LZH-ang/8051_digital-clock/README.md

# 8051_digital clock_myfristrepository!
look! u found me! 

it's my frist repository!

PCB SOFTWARE : AD20.2.8

PROGRAMME SOFTWARE : KEIL V5.34

MCU : STC8H1K17

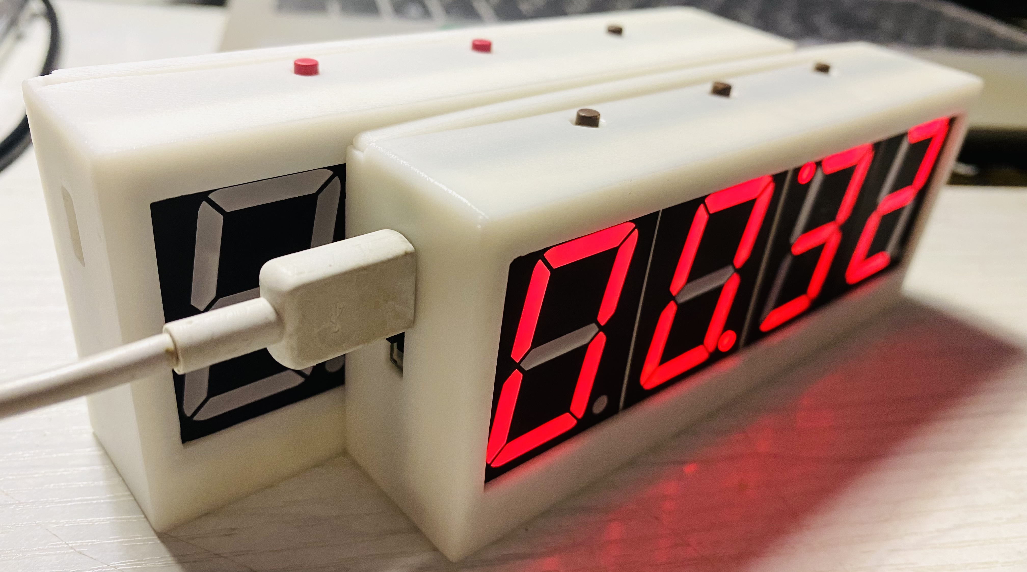
[picture p1: IMG/IMG_1017.JPG]
