LZH-ang/8051_digital-clock/8051_eclock_DEMO/Code/三菱按键/”三菱“开关编程分享/2IO检测6按键原理图分析 - 哔哩哔哩 - www.bilibili.com.pdf

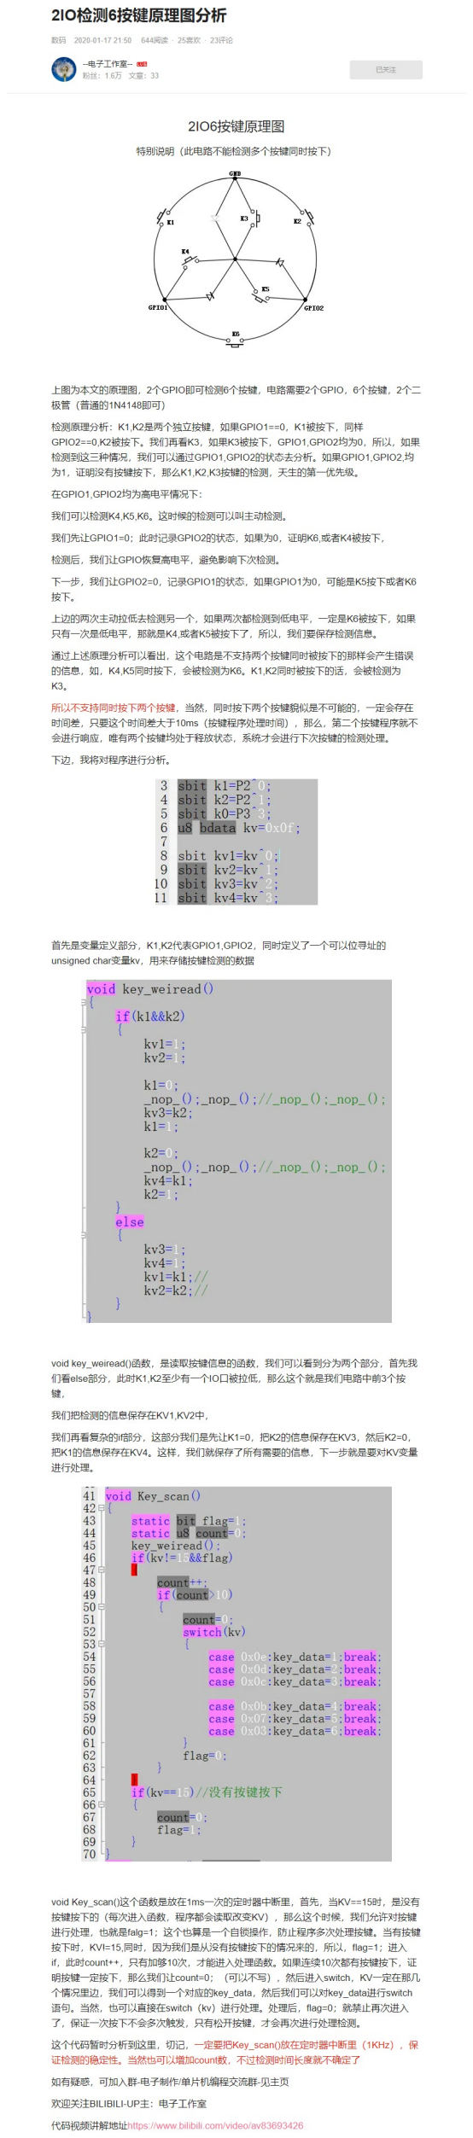
[picture p2: page 1]
