LZH-ang/8051_digital-clock/8051_eclock_DEMO/Code/三菱按键/”三菱“开关编程分享/2个IO检测6个按键.png

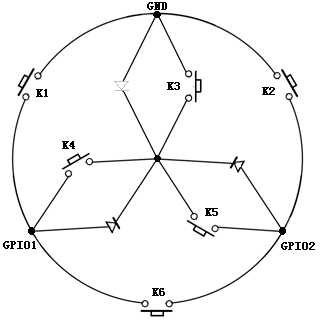
8051_eclock_DEMO/Code/三菱按键/”三菱“开关编程分享/2个IO检测6个按键.png
