LZH-ang/8051_digital-clock/8051_eclock_DEMO/PCB file/1W LED 驱动器700mA PWM调光输入5-35V DC-DC恒流模块-淘宝网 - item.taobao.com.png

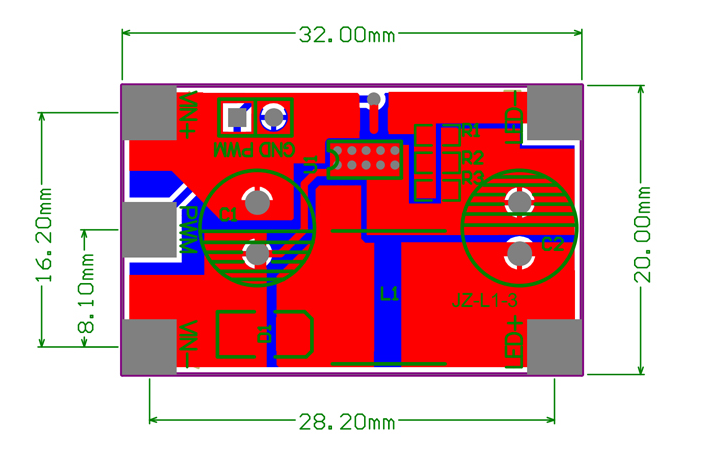
8051_eclock_DEMO/PCB file/1W LED 驱动器700mA PWM调光输入5-35V DC-DC恒流模块-淘宝网 - item.taobao.com.png
