LZH-ang/8051_digital-clock/8051_eclock_DEMO/PCB file/PCB.png

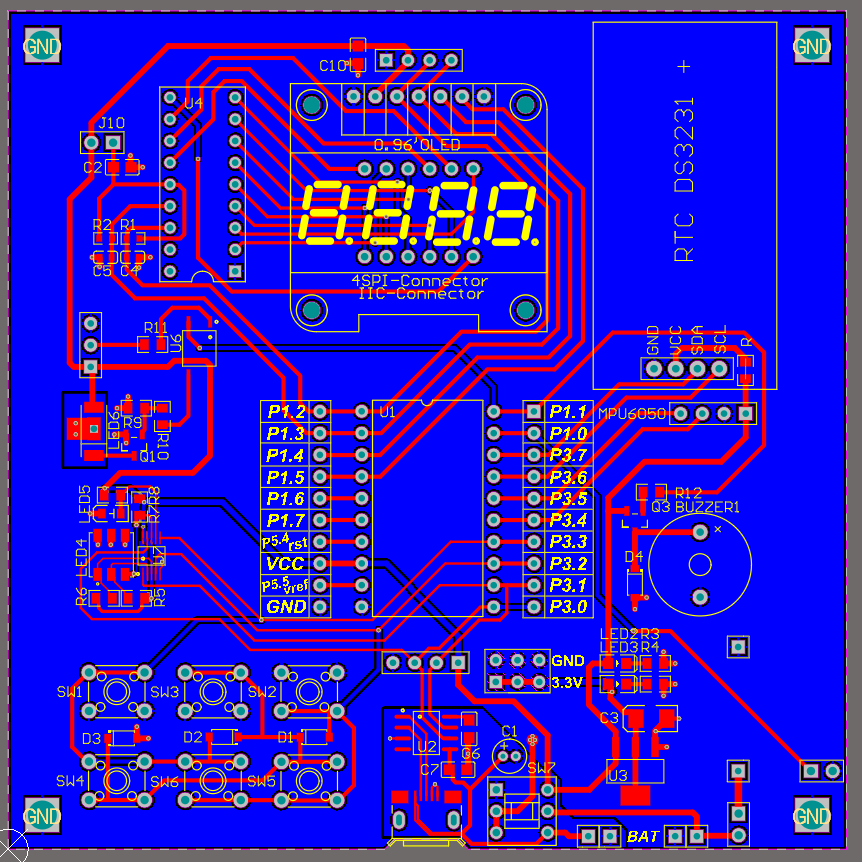
8051_eclock_DEMO/PCB file/PCB.png
