LZH-ang/8051_digital-clock/IMG/IMG_1015.JPG

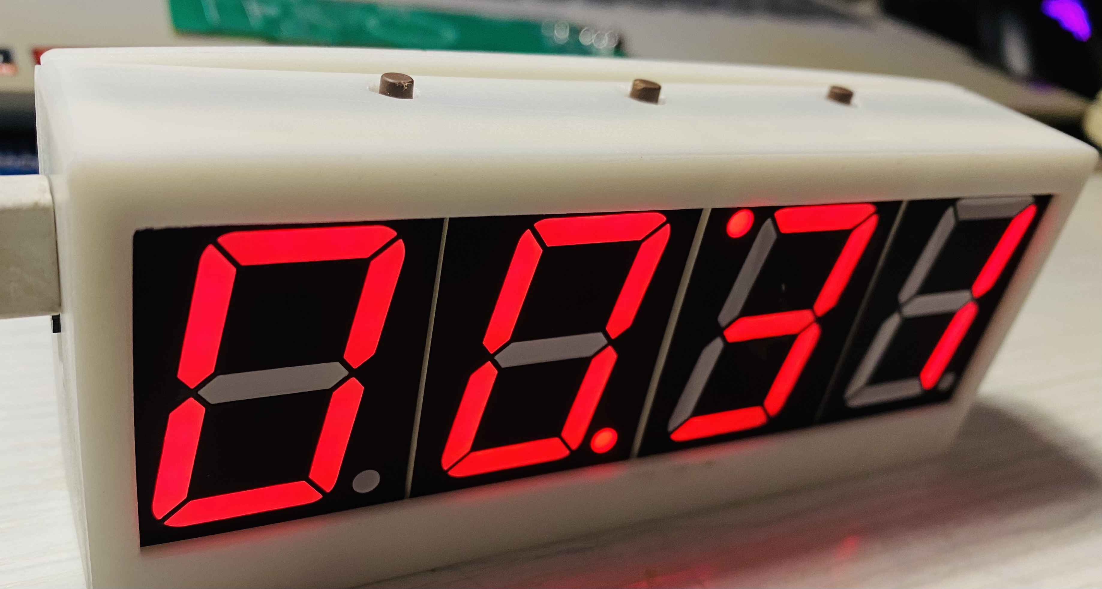
IMG/IMG_1015.JPG
