LZH-ang/8051_digital-clock/IMG/IMG_1016.JPG

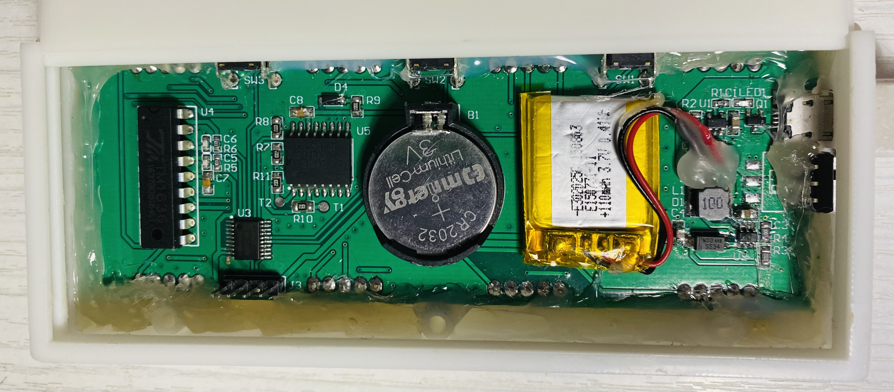
IMG/IMG_1016.JPG
