LZH-ang/8051_digital-clock/8051_eclock/工程文件 file project/PCB_Project/床头表PCB_Project.pdf

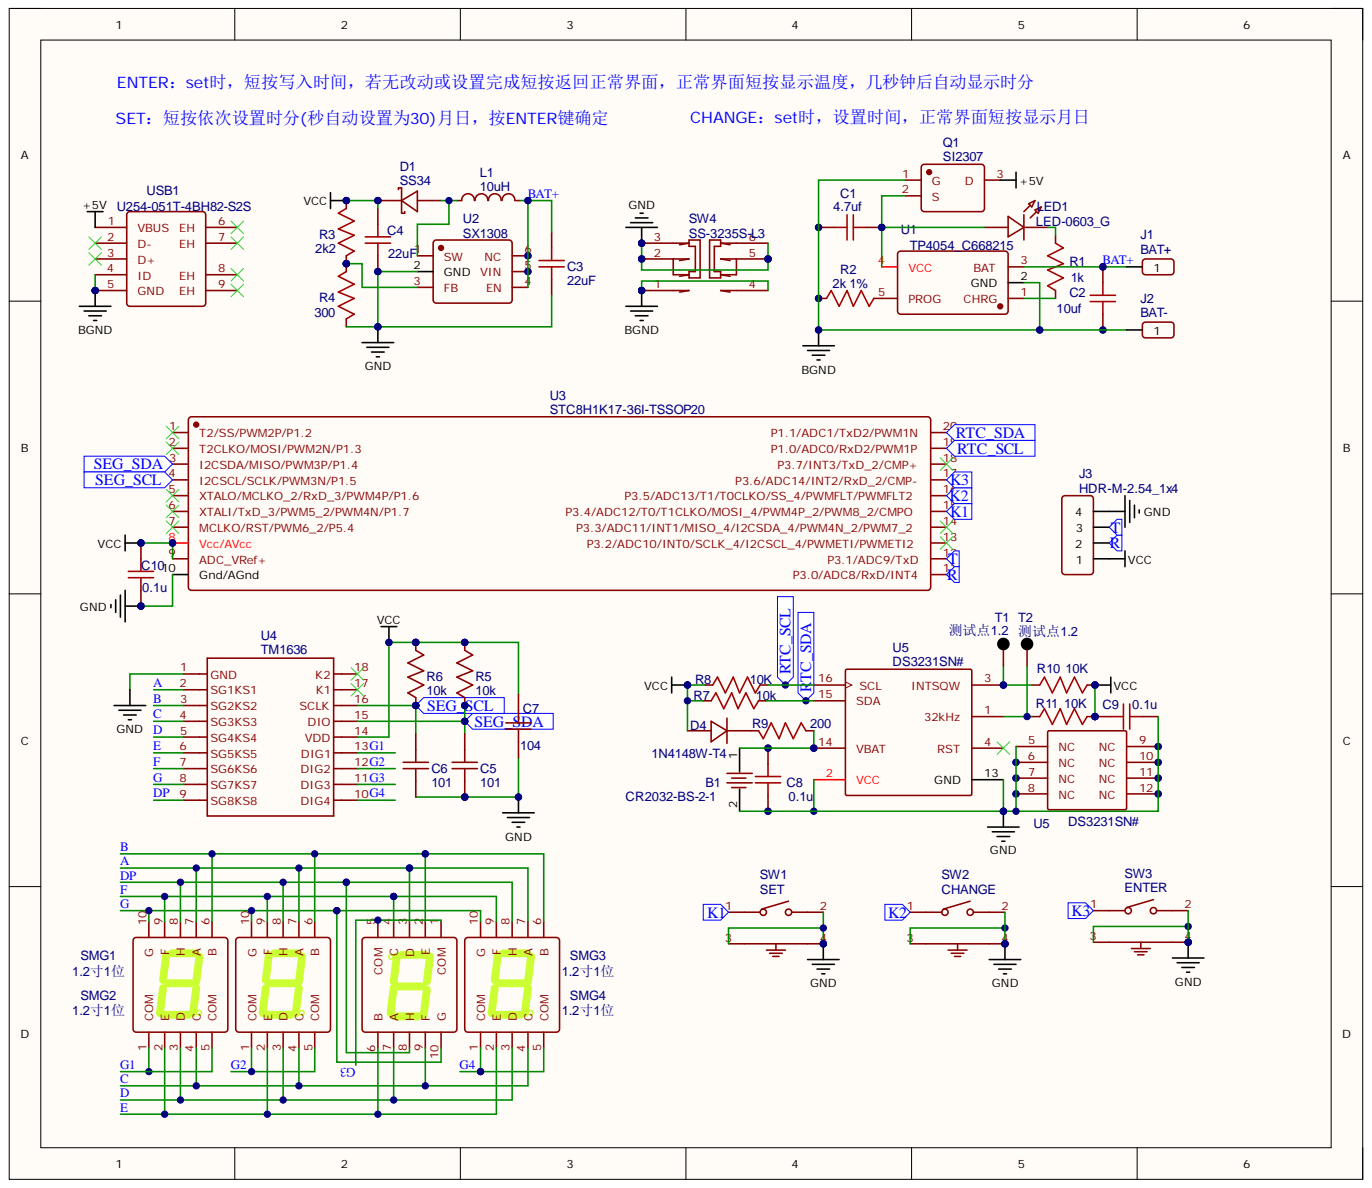
[picture p8: page 1]

ENTER：set时，短按写入时间，若无改动或设置完成短按返回正常界面，正常界面短按显示温度，几秒钟后自动显示时分

SET：短按依次设置时分(秒自动设置为30)月日，按ENTER键确定

CHANGE：set时，设置时间，正常界面短按显示月日

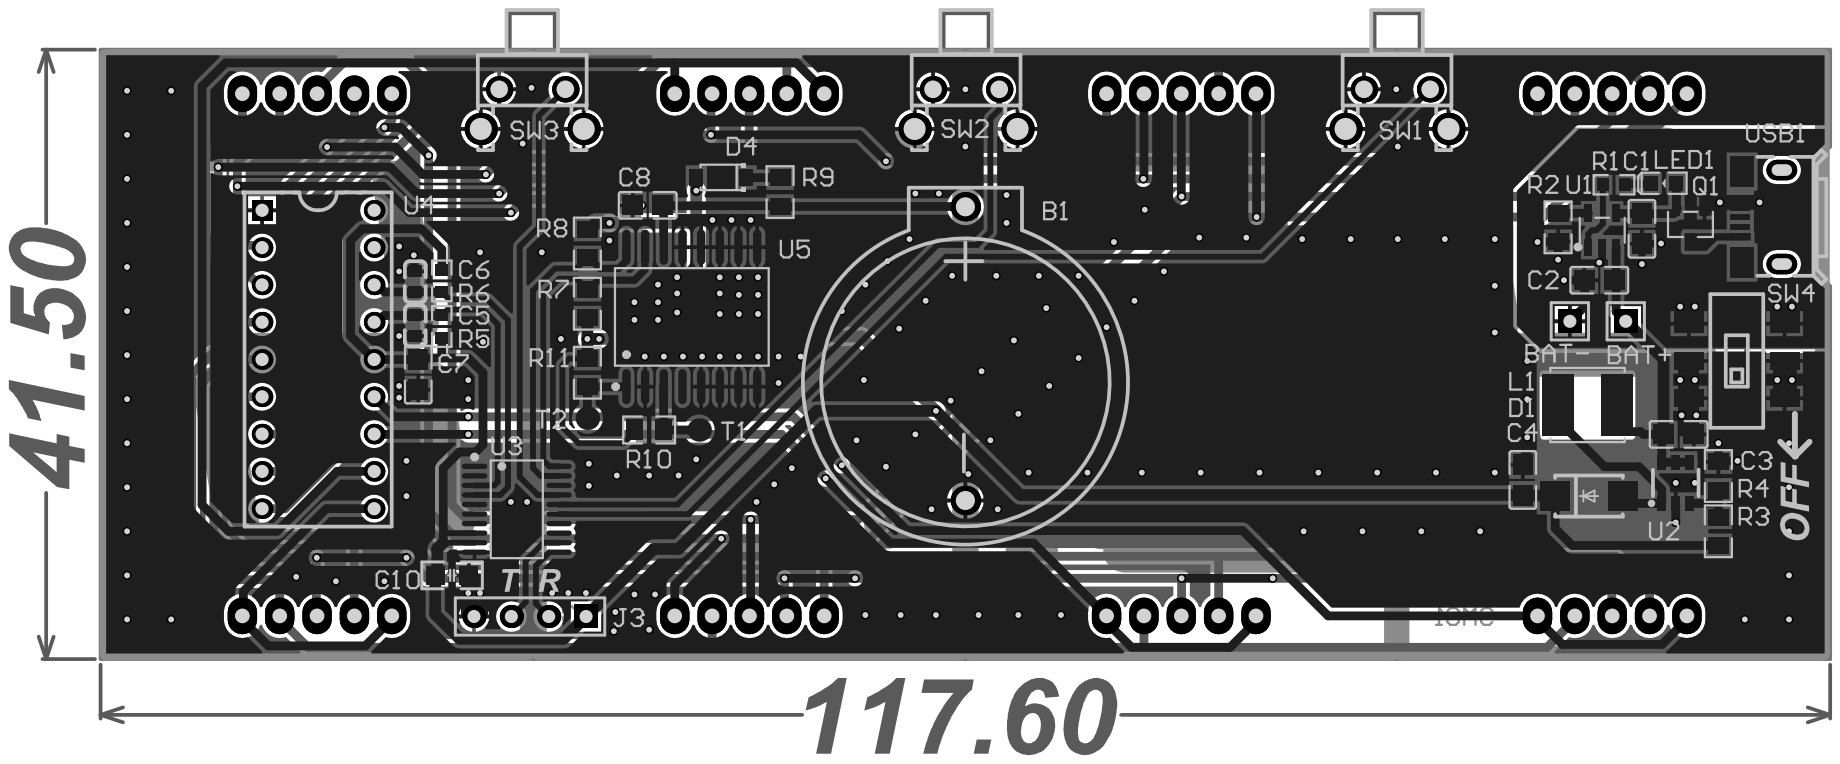
[picture p9: page 2]

Comment | Description | Designator | Footprint | LibRef | Quantity
CR2032-BS-2-1 | | B1 | BAT-TH_BS-2-1 | CR2032-BS-2-1 | 1
4.7uf | | C1 | C0805 | 4.7uf | 1
10uf | | C2 | C0805 | 10uf | 1
22uF | | C3, C4 | C0805 | 22uF | 2
101 | | C5, C6 | C0603 | 101 | 2
104 | | C7 | C0805 | 104 | 1
0.1u | | C8, C9, C10 | C0805 | 0.1u | 3
SS34 | | D1 | DO-214AC_L4.3-W2.7-LS5.3-RD | SS34 | 1
1N4148W-T4 | | D4 | SOD-123_L2.8-W1.8-LS3.7-RD | 1N4148W-T4 | 1
BAT+ | | J1 | HDR-M-2.54_1X1 | BAT+ | 1
BAT- | | J2 | HDR-M-2.54_1X1 | BAT- | 1
HDR-M-2.54_1x4 | | J3 | HDR-M-2.54_1X4 | HDR-M-2.54_1x4 | 1
10uH | | L1 | IND-SMD_L5.0-W5.0 10uH | | 1
LED-0603_G | | LED1 | LED0603_GREEN | LED-0603_G | 1
SI2307 | | Q1 | SOT-23-3_L3.0-W1.7-P0.95-LS2.9-BR | SI2307 | 1
1k | | R1 | R0603 | 1k | 1
2k 1% | | R2 | R0805 | 2k 1% | 1
2k2 | | R3 | R0805 | 2k2 | 1
300 | | R4 | R0805 | 300 | 1
10k | | R5, R6 | R0603 | 10k | 2
10k | | R7, R8, R10, R11 | R0805 | 10k | 4
200 | | R9 | R0805 | 200 | 1
1.2寸1位 | | SMG1, SMG2, SMG3, SMG4 | 1.2寸数码管 | 1.2寸1位 | 4
SET | | SW1 | SW-TH_TC-1102N-C-QL-B | SET | 1
CHANGE | | SW2 | SW-TH_TC-1102N-C-QL-B | CHANGE | 1
ENTER | | SW3 | SW-TH_TC-1102N-C-QL-B | ENTER | 1
SS-3235S-L3 | | SW4 | SW-SMD_SS-3235S-L3.00 | SS-3235S-L3 | 1
测试点1.2 | | T1, T2 | 测试点 | 测试点1.2 | 2
TP4054_C668215 | | U1 | SOT-23-5_L3.0-W1.7-P0.95-LS2.8-BL | TP4054_C668215 | 1
SX1308 | | U2 | SOT-23-6_L2.9-W1.6-P0.95-LS2.8-BR | SX1308 | 1
STC8H1K17-36I-TSSOP20 | | U3 | TSSOP-20_L6.5-W4.4-P0.65-LS6.4-BL | STC8H1K17-36I-TSSOP20 | 1
TM1636 | | U4 | DIP18-2.54-22.8X7.62MM | TM1636 | 1
DS3231SN# | | U5 | SOIC-16_L10.3-W7.5-P1.27-LS10.3-BL | DS3231SN# | 2
U254-051T-4BH82-S2S | | USB1 | MICRO-USB-SMD_U254-051T-4BH82-S2S | U254-051T-4BH82-S2S | 1
