LZH-ang/8051_digital-clock/(list of files, drawings)

Other design files:
8051_eclock/工程文件 file project/PCB_Project/PCB_床头灯_2022-02-08.pcbdoc
8051_eclock/工程文件 file project/PCB_Project/sch_2022-04-21.schdoc
8051_eclock/工程文件 file project/PCB_Project/床头表PCB_Project.PrjPcb
8051_eclock_DEMO/PCB file/Project file/PCB_STC8方案测试板_2022-01-08.pcbdoc
8051_eclock_DEMO/PCB file/Project file/sch_2022-04-21.schdoc
8051_eclock_DEMO/PCB file/Project file/stc8-PCB_Project/stc8-PCB_Project.PrjPcb
