LZH-ang/8051_digital-clock/8051_eclock/工程文件 file project/Program_V1.0/main.c

#include <STC8.H>
#include "intrins.h"
#include "delay.h"
#include "3231.h"
#include "TM1637.h"
#include "key.h"

u8 const num[10]={0x3F,0x06,0x5B,0x4F,0x66,0x6D,0x7D,0x07,0x7f,0x6F};
u8 sec_dot=0,cp=0,light=3;
bit light_con=0,TM0_flag=0;//自动亮度控制
	
void get_Temperature();	 //温度获取 显示
void Timer0Init(void)		//5毫秒@11.0592MHz
{
	AUXR |= 0x80;		//定时器时钟1T模式
	TMOD &= 0xF0;		//设置定时器模式
	TL0 = 0x00;		//设置定时初始值
	TH0 = 0x28;		//设置定时初始值
	TF0 = 0;		//清除TF0标志
	TR0 = 1;		//定时器0开始计时
	ET0 = 1;
	EA = 1;
}

void main()
{
	P1M0 = 0x30;//开漏
	P1M1 = 0x30;
	P3M1 = 0x00;//准双向
	P3M0 = 0x00;
	Timer0Init();
	while(cp<=20);cp = 0;//等待供电稳定
//	ModifyTime(DS3231_SECOND,30);_nop_();//测试用
//	ModifyTime(DS3231_MINUTE,8);_nop_();
//	ModifyTime(DS3231_HOUR,22);_nop_();
//	ModifyTime(DS3231_YEAR,22);_nop_();
//	ModifyTime(DS3231_MONTH,1);_nop_();
//	ModifyTime(DS3231_DAY,15);_nop_();
//	ModifyTime(DS3231_WEEK,7);_nop_();
	while(1)
	{
		Key_Set();
		Key_Change();
		Key_Enter();	
		if(cp ==70)//每大约300ms读一次时间
		{
			cp = 0;
			year = read_random(DS3231_YEAR);_nop_();
			mon  = read_random(DS3231_MONTH);_nop_();
			day  = read_random(DS3231_DAY);_nop_();
			hour = read_random(DS3231_HOUR);_nop_();
			min  = read_random(DS3231_MINUTE);_nop_();
			sec  = read_random(DS3231_SECOND);_nop_();
			week = read_random(DS3231_WEEK);_nop_();
			if(light_con == 0)
			{
				if((hour >= 6)&&(hour < 23))light = 5;//23-6点低亮度，6-23点高亮度
				else light = 1;
				light_con = 1;
			}
			else if((!min)&&(hour == 6 || hour == 23))light_con = 0;
			if(sec%2)sec_dot=0x80;else sec_dot=0;//小数点秒闪烁		
		}	
		if(TM0_flag)
		{
			if(mode == 0)//正常界面
			{	
				if(dis_temp == 1)get_Temperature();
				else
				{
					if(dis_time == 0)display_4seg(num[hour/10],num[hour%10]|sec_dot,num[min/10]|sec_dot,num[min%10],light);   //显示时分
					if(dis_time == 1)display_4seg(num[mon/10],num[mon%10]|0x80,num[day/10],num[day%10],light);	//显示月日
				}												
			}
			if(mode == 1)//设置界面
			{
				if(temp){temp = 0;hour_t = hour;min_t = min;sec_t = sec;mon_t = mon;day_t = day;}//每进入设置界面读取当前时间
				if(dis_format == 1)display_4seg(num[hour_t/10],num[hour_t%10],0x08,0x08,light);			 //时调整界面
				if(dis_format == 2)display_4seg(0x08,0x08,num[min_t/10],num[min_t%10],light);				 //分调整界面
				if(dis_format == 3)display_4seg(num[mon_t/10],num[mon_t%10],0x08,0x08,light);				 //月调整界面
				if(dis_format == 4)display_4seg(0x08,0x08,num[day_t/10],num[day_t%10],light);				 //日调整界面
			}
		}
	}
}

void TM0_Isr() interrupt 1
{
	cp++;
	TM0_flag = ~TM0_flag;
}

void get_Temperature()	 //温度获取 显示
{
  uchar Tem_L; 
	uchar Tem_H;
	
  Tem_H=read_randomTmp(DS3231_TEMPERATUREH);    //温度 高字节 整数部分
	Tem_L=read_randomTmp(DS3231_TEMPERATUREL);	 //温度 低字节 小数部分
	Tem_L = (Tem_L>>6)*0.25*100;	 
	
	if(!(Tem_H & 0x80))	//正温度
	{ 
		/********显示温度*********/
		if(Tem_H/10 > 0)
			display_1seg(num[Tem_H/10],0,light);//显示温度十位
		else
			display_1seg(0x00,0,light);//否则温度十位为0不显示
		  display_1seg(num[Tem_H%10]|0x80,1,light);//显示温度个位，显示小数点
		  display_1seg(num[Tem_L/10],2,light);//显示温度小数第1位
		  display_1seg(num[Tem_L%10],3,light);//显示温度小数第2位
	}
	else
	{ 
		if(Tem_H & 0x80)	 //负温度
		{
			display_4seg(0x08,0x08,0x08,0x08,light);
		}
	}
}	
