LZH-ang/8051_digital-clock/8051_eclock_DEMO/Code/DS3231test/TM1637.c

#include "TM1637.h"
#include "delay.h"

void I2CStart()
{
	CLK = 1;
	DIO = 1;
	Delay2us();
	DIO = 0;
}
void I2CAsk()
{
	CLK = 0;
	Delay5us();
	while(DIO);
	CLK = 1;
	Delay2us();
	CLK = 0;
}
void I2CStop()
{
	CLK = 0;
	Delay2us();
	DIO = 0;
	Delay2us();
	CLK = 1;
	Delay2us();
	DIO = 1;
}
void I2CWriteByte(u8 dat)
{
	u8 i;
	for(i=0;i<8;i++)
	{
		CLK = 0;
		if(dat&0x01)
		{
			DIO = 1;
		}
		else
		{
			DIO = 0;
		}
		Delay3us();
		dat>>=1;
		CLK = 1;
		Delay3us();
	}
}
void Tm1636_write_display(u8 mode)//1:自动;0;固定
{
	I2CStart();
	if(mode)I2CWriteByte(0x40);	//40H 地址自动加1 模式,
	else I2CWriteByte(0x44);		//44H 固定地址模式
	I2CAsk();										
	I2CStop();	
}
void Tm1636_set_segbit(u8 addr)//四位:0-3,自动模式必须是0
{
	I2CStart();
	I2CWriteByte(0xC0+addr);		//设置首地址 C0 C1 C2 C3
	I2CAsk();
}
void Tm1636_display(u16 num)
{
	I2CWriteByte(num);
	I2CAsk();
}
void Tm1636_discon(u8 light)//亮度:0-7
{
	I2CStop();
	I2CStart();
	I2CWriteByte(0x88+light);//8F最亮 88-8F 
	I2CAsk();
	I2CStop();
}
void display_4seg(u8 G1,u8 G2,u8 G3,u8 G4)//四位数码管显示
{
	Tm1636_write_display(1);
	Tm1636_set_segbit(0);
	Tm1636_display(G1);
	Tm1636_display(G2);
	Tm1636_display(G3);
	Tm1636_display(G4);
	Tm1636_discon(7);
}
