LZH-ang/8051_digital-clock/(commit log)

2022-07-05 update files
    [3231.obj, PCB_床头灯_2022-02-08.pcbdoc, STARTUP.obj, TM1637.obj, delay.obj, key.obj, main.obj, mian.obj]
2022-07-05 update files
    i delete useless files
    [PCB_床头灯_2022-02-08.pcbdoc, sch_2022-04-21.schdoc, 床头表PCB_Project.PrjPcb]
2022-07-30 Add 8051_Eclock_DEMO Files
    [PCB_STC8方案测试板_2022-01-08.pcbdoc, sch_2022-04-21.schdoc, stc8-PCB_Project.PrjPcb]
